kamilix2003/esp-home-sensor/README.md

# esp-home-sensor

Wireless ESP32-C6 based home environmental sensor powered by single Li-ion 18650 cell, running ESP home firmware optimized for battery life which is to be measured in months instead of days.

<figure style="text-align:center;">
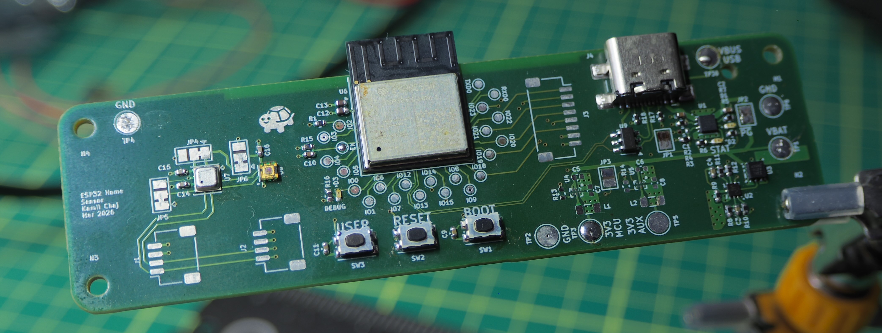
[picture p1: docs/img/full.JPG]
pcb_full
  
</figure>
