kamilix2003/esp-home-sensor/docs/todo.md

# Things to impove in next revision

## Known issues

- DC/DC issues with assembly

## additional features / changes

- additional Battery connector or contacts
- test points for esp32 and other ICs on the backside
- cutout around temperature sennsor
