kamilix2003/esp-home-sensor/hardware/battery_protection/battery_protection.kicad_pcb

## KiCad design hardware/battery_protection/battery_protection.kicad_pcb (2026-10-13)

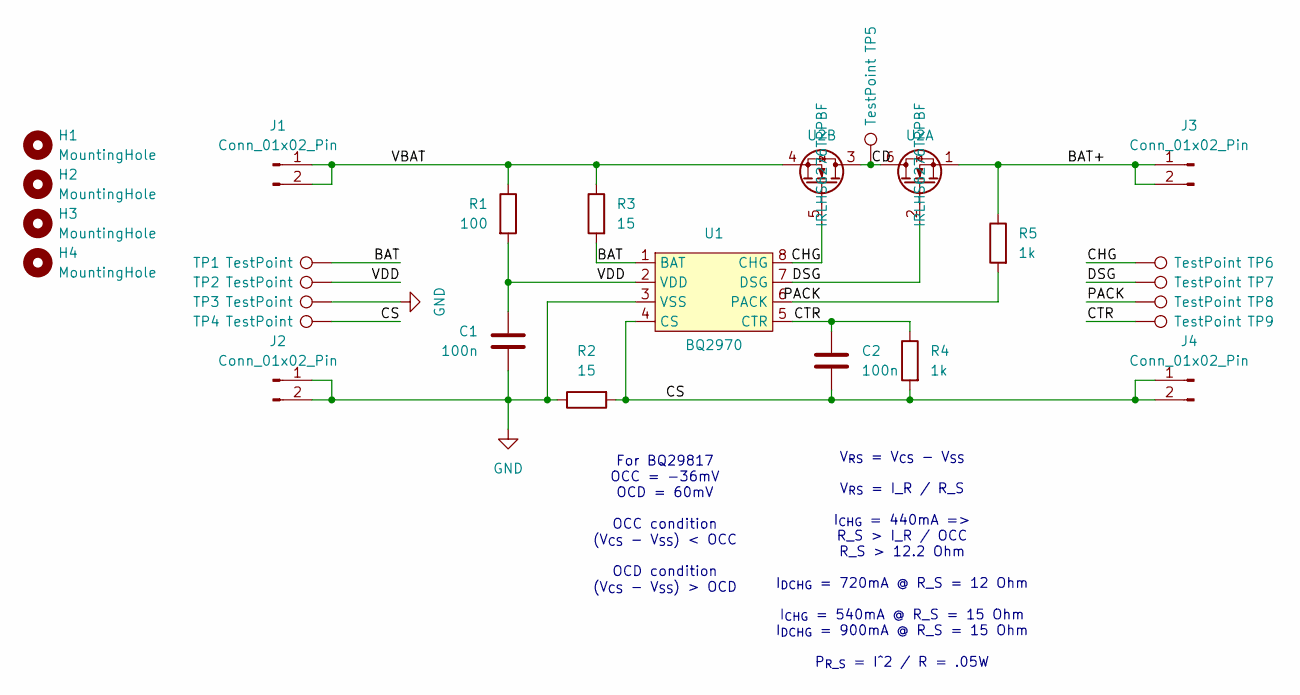
[picture p8: schematic battery_protection.kicad_sch]

Parts:
C1, C2: 100n; C_0402_1005Metric
H1, H2, H3, H4: MountingHole; MountingHole_2.2mm_M2
J1, J2, J3, J4: Conn_01x02_Pin; PinHeader_1x02_P2.54mm_Vertical
R1: 100; R_0402_1005Metric
R2, R3: 15; R_0402_1005Metric
R4, R5: 1k; R_0402_1005Metric
TP1, TP2, TP3, TP4, TP5, TP6, TP7, TP8, TP9: TestPoint; TestPoint_THTPad_D1.0mm_Drill0.5mm
U1: BQ2970; QFN-8_1.5x1.5_Pitch0.5mm
U2: IRLHS6276TRPBF; QFN-6_2x2_Pitch0.65mm

Connections:
/BAT: R3.2, TP1.1 (1_1), U1.1 (BAT)
/BAT+: J3.1, J3.2, R5.1, U2.1
/CD: TP5.1 (1_1), U2.3, U2.6
/CHG: TP6.1 (1_1), U1.8 (CHG), U2.5
/CS: C2.2, J4.1, J4.2, R2.2, R4.2, TP4.1 (1_1), U1.4 (CS)
/CTR: C2.1, R4.1, TP9.1 (1_1), U1.5 (CTR)
/DSG: TP7.1 (1_1), U1.7 (DSG), U2.2
/PACK: R5.2, TP8.1 (1_1), U1.6 (PACK)
/VBAT: J1.1, J1.2, R1.1, R3.1, U2.4
/VDD: C1.1, R1.2, TP2.1 (1_1), U1.2 (VDD)
GND: C1.2, J2.1, J2.2, R2.1, TP3.1 (1_1), U1.3 (VSS)

Notes on the sheet:
V_{RS} = V_{CS} - V_{SS} V_{RS} = I_R / R_S I_{CHG} = 440mA => R_S > I_R / OCC R_S > 12.2 Ohm I_{DCHG} = 720mA @ R_S = 12 Ohm I_{CHG} = 540mA @ R_S = 15 Ohm I_{DCHG} = 900mA @ R_S = 15 Ohm P_{R_S} = I^2 / R = .05W
For BQ29817 OCC = -36mV OCD = 60mV OCC condition (V_{CS} - V_{SS}) < OCC OCD condition (V_{CS} - V_{SS}) > OCD

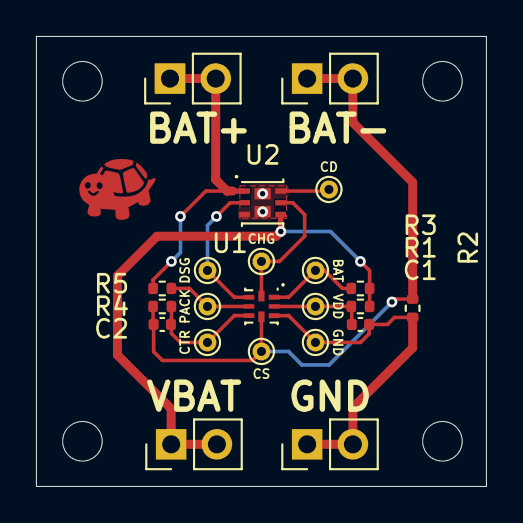
[picture p9: board battery_protection.kicad_pcb from above]

Board: 2 copper layers, 25.0 x 25.0 mm, 26 parts (0 on the bottom side), 11 nets.
