kamilix2003/esp-home-sensor/hardware/battery_charger/battery_charger.kicad_pcb

## KiCad design hardware/battery_charger/battery_charger.kicad_pcb (2026-10-13)

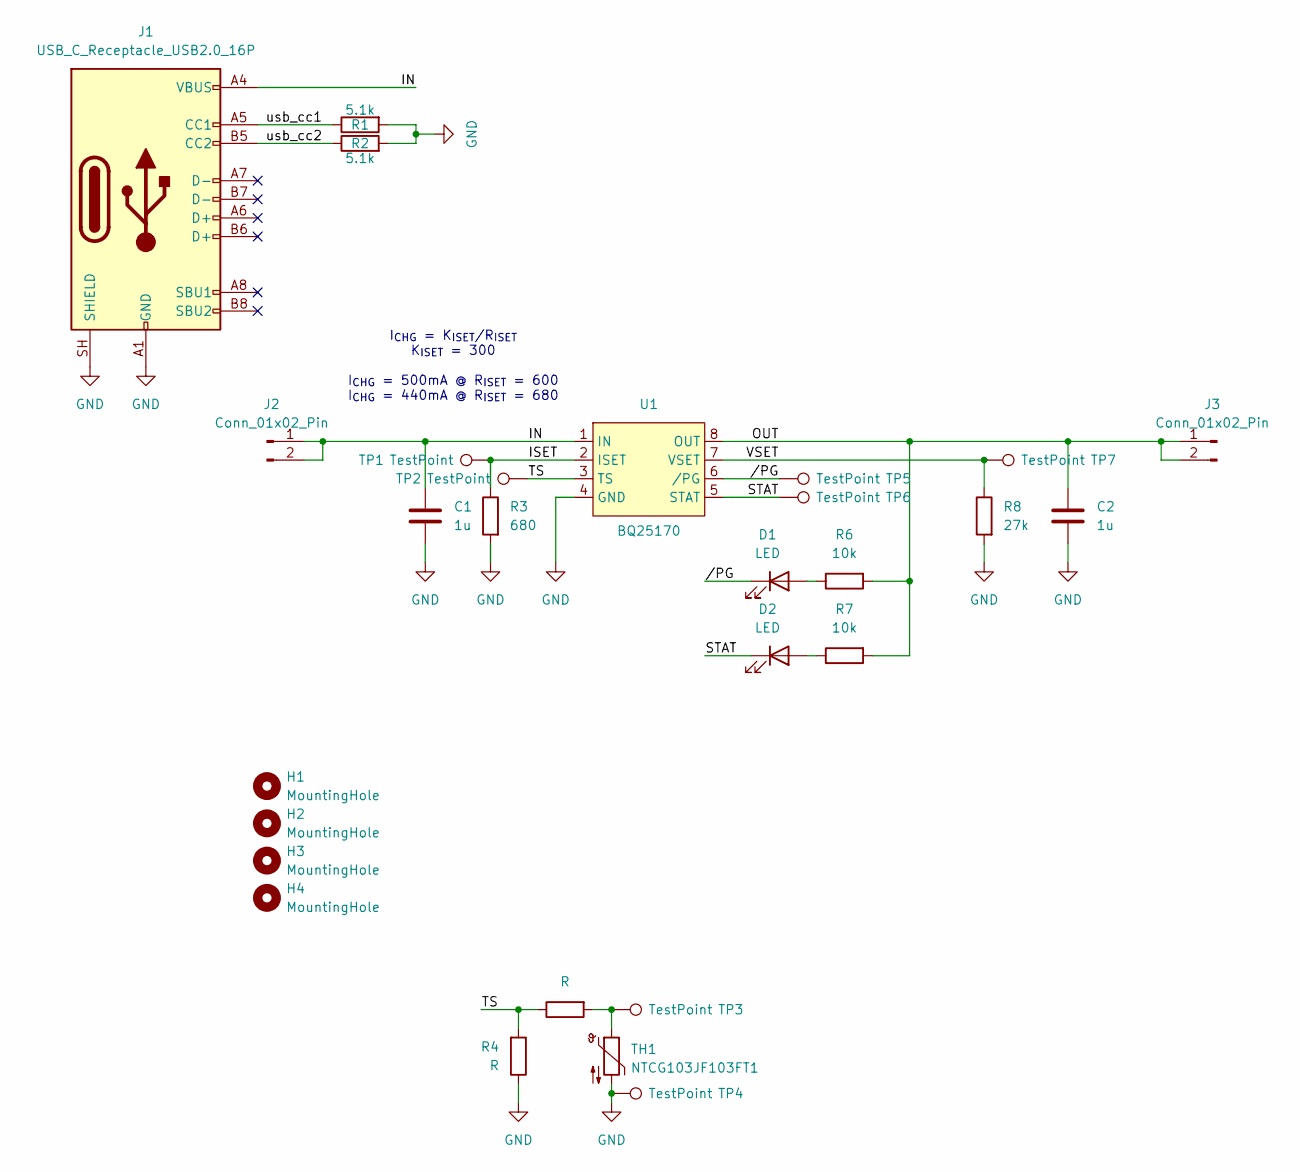
[picture p10: schematic battery_charger.kicad_sch]

Parts:
C1, C2: 1u; C_0402_1005Metric
D1, D2: LED; LED_0402_1005Metric
H1, H2, H3, H4: MountingHole; MountingHole_2.2mm_M2
J1: USB_C_Receptacle_USB2.0_16P; USB_C_Receptacle_GCT_USB4110
J2, J3: Conn_01x02_Pin; PinHeader_1x02_P2.54mm_Vertical
R1, R2: 5.1k; R_0402_1005Metric
R3: 680; R_0402_1005Metric
R4, R5: R; R_0402_1005Metric
R6, R7: 10k; R_0402_1005Metric
R8: 27k; R_0402_1005Metric
TH1: NTCG103JF103FT1; R_0603_1608Metric
TP1, TP2, TP3, TP4, TP5, TP6, TP7: TestPoint; TestPoint_THTPad_D1.0mm_Drill0.5mm
U1: BQ25170; QFN-8_EP_2x2_Pitch0.5mm

Connections:
/IN: C1.1, J1.A4 (VBUS), J1.A9 (VBUS), J1.B4 (VBUS), J1.B9 (VBUS), J2.1, J2.2, U1.1 (IN)
/ISET: R3.1, TP1.1 (1_1), U1.2 (ISET)
/OUT: C2.1, J3.1, J3.2, R6.2, R7.2, U1.8 (OUT)
/STAT: D2.1 (K), TP6.1 (1_1), U1.5 (STAT)
/TS: R4.2, R5.1, TP2.1 (1_1), U1.3 (TS)
/VSET: R8.1, TP7.1 (1_1), U1.7 (VSET)
/usb_cc1: J1.A5 (CC1), R1.1
/usb_cc2: J1.B5 (CC2), R2.1
//PG: D1.1 (K), TP5.1 (1_1), U1.6 (/PG)
GND: C1.2, C2.2, J1.A1 (GND), J1.A12 (GND), J1.B1 (GND), J1.B12 (GND), J1.SH (SHIELD), R1.2, R2.2, R3.2, R4.1, R8.2, TH1.2, TP4.1 (1_1), U1.4 (GND)
unnamed: D1.2 (A), R6.1
unnamed: D2.2 (A), R7.1
unnamed: R5.2, TH1.1, TP3.1 (1_1)

Notes on the sheet:
I_{CHG} = K_{ISET}/R_{ISET} K_{ISET} = 300 I_{CHG} = 500mA @ R_{ISET} = 600 I_{CHG} = 440mA @ R_{ISET} = 680

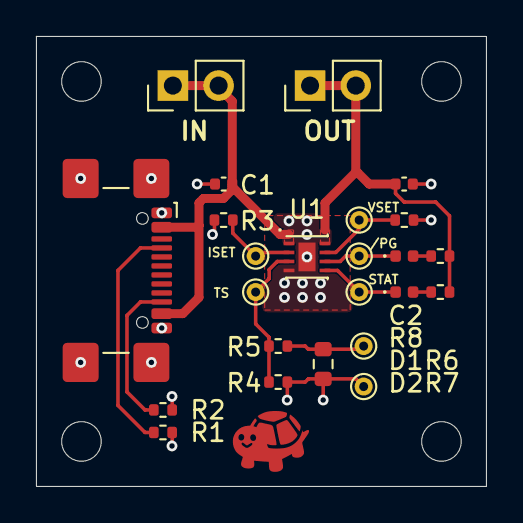
[picture p11: board battery_charger.kicad_pcb from above]

Board: 2 copper layers, 25.0 x 25.0 mm, 28 parts (0 on the bottom side), 13 nets.
