kamilix2003/esp-home-sensor/hardware/esp_home_sensor/esp_home_sensor.kicad_pcb

## KiCad design hardware/esp_home_sensor/esp_home_sensor.kicad_pcb (2026-04-01)

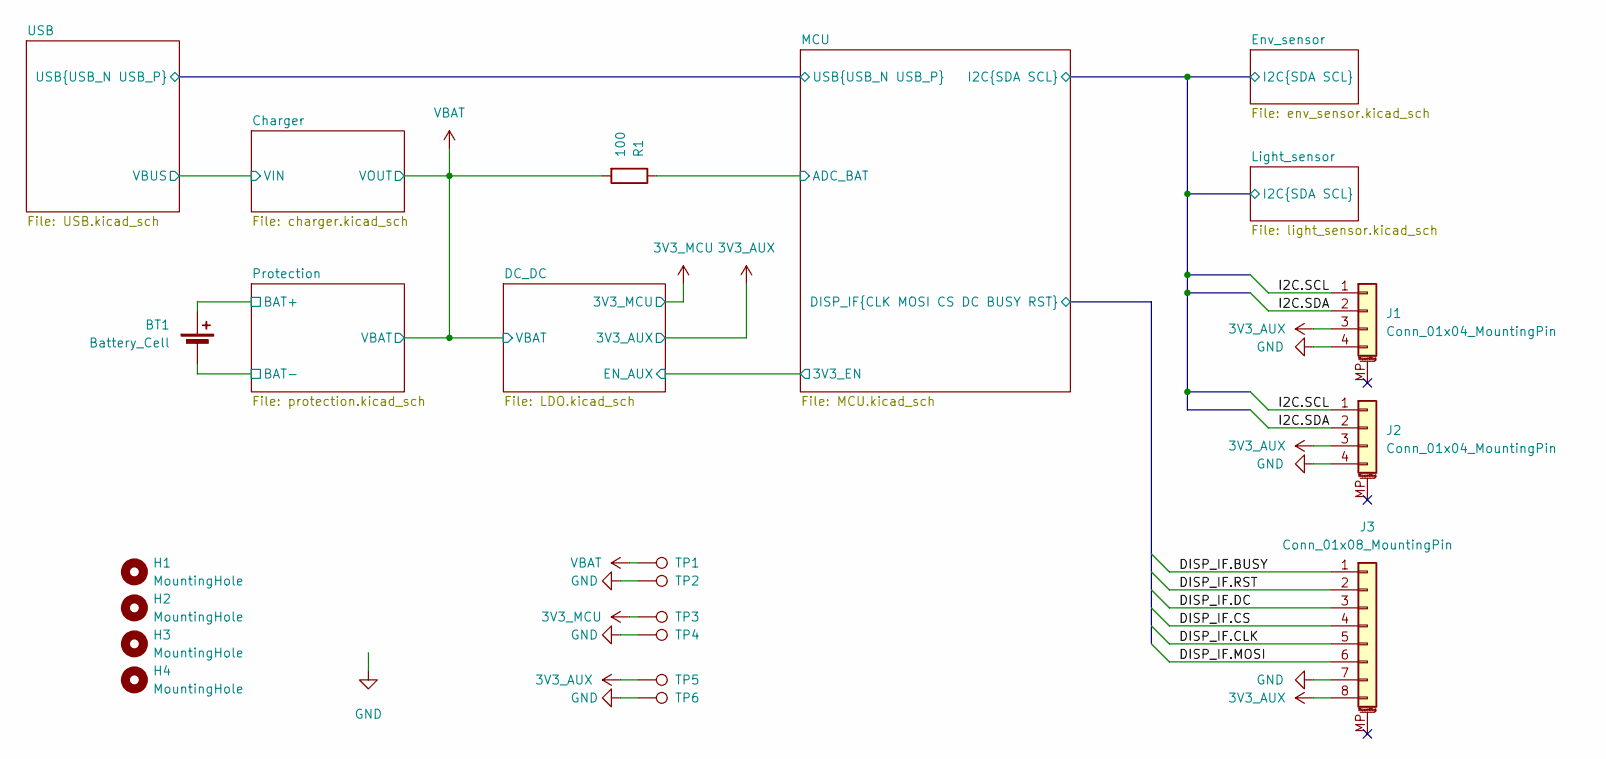
[picture p12: schematic esp_home_sensor.kicad_sch]

Parts:
BT1: Battery_Cell
H1, H2, H3, H4: MountingHole; MountingHole_2.2mm_M2
J1, J2: Conn_01x04_MountingPin; JST_SH_SM04B-SRSS-TB_1x04-1MP_P1.00mm_Horizontal
J3: Conn_01x08_MountingPin; JST_SH_SM08B-SRSS-TB_1x08-1MP_P1.00mm_Horizontal
R1: 100; R_0402_1005Metric
TP1, TP2, TP3, TP4, TP5, TP6: TestPoint; TestPoint_Pad_D2.5mm

Connections:
3V3_AUX: J1.3, J2.3, J3.8, TP5.1 (1_1); also elsewhere on the board
3V3_MCU: TP3.1 (1_1); also elsewhere on the board
/Env_sensor/I2C.SCL: J1.1, J2.1; also elsewhere on the board
/Env_sensor/I2C.SDA: J1.2, J2.2; also elsewhere on the board
/MCU/ADC_BAT: R1.1; also elsewhere on the board
/MCU/DISP_IF.BUSY: J3.1; also elsewhere on the board
/MCU/DISP_IF.CLK: J3.5; also elsewhere on the board
/MCU/DISP_IF.CS: J3.4; also elsewhere on the board
/MCU/DISP_IF.DC: J3.3; also elsewhere on the board
/MCU/DISP_IF.MOSI: J3.6; also elsewhere on the board
/MCU/DISP_IF.RST: J3.2; also elsewhere on the board
/Protection/BAT+: BT1.1 (+); also elsewhere on the board
/Protection/BAT-: BT1.2 (-); also elsewhere on the board
GND: J1.4, J2.4, J3.7, TP2.1 (1_1), TP4.1 (1_1), TP6.1 (1_1); also elsewhere on the board
VBAT: R1.2, TP1.1 (1_1); also elsewhere on the board

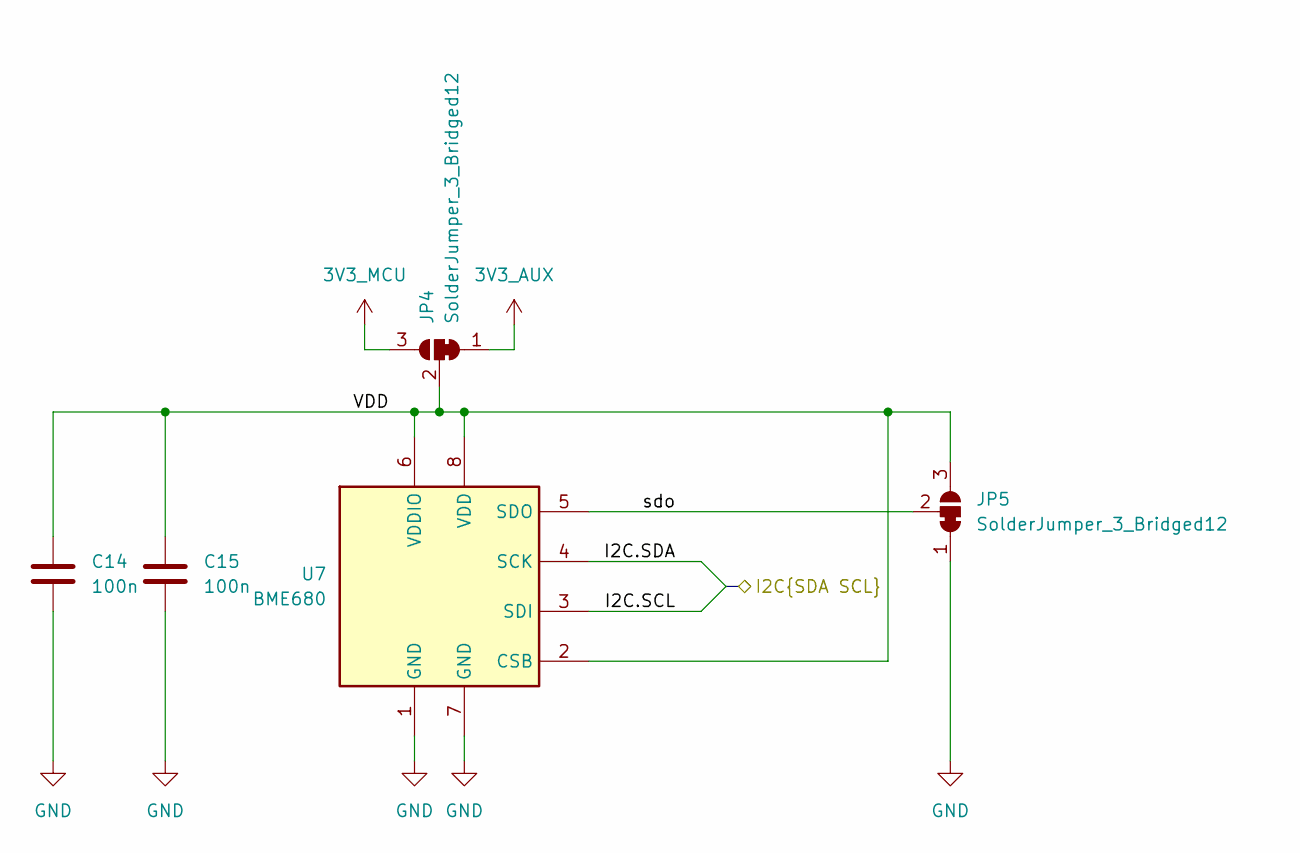
[picture p13: schematic env_sensor.kicad_sch]

Parts:
C14, C15: 100n; C_0402_1005Metric
JP4, JP5: SolderJumper_3_Bridged12; SolderJumper-3_P1.3mm_Bridged12_Pad1.0x1.5mm
U7: BME680; Bosch_LGA-8_3x3mm_P0.8mm_ClockwisePinNumbering

Connections:
3V3_AUX: JP4.1 (A); also elsewhere on the board
3V3_MCU: JP4.3 (B); also elsewhere on the board
/Env_sensor/I2C.SCL: U7.3 (SDI); also elsewhere on the board
/Env_sensor/I2C.SDA: U7.4 (SCK); also elsewhere on the board
/Env_sensor/VDD: C14.1, C15.1, JP4.2 (C), JP5.3 (B), U7.2 (CSB), U7.6 (VDDIO), U7.8 (VDD)
/Env_sensor/sdo: JP5.2 (C), U7.5 (SDO)
GND: C14.2, C15.2, JP5.1 (A), U7.1 (GND), U7.7 (GND); also elsewhere on the board

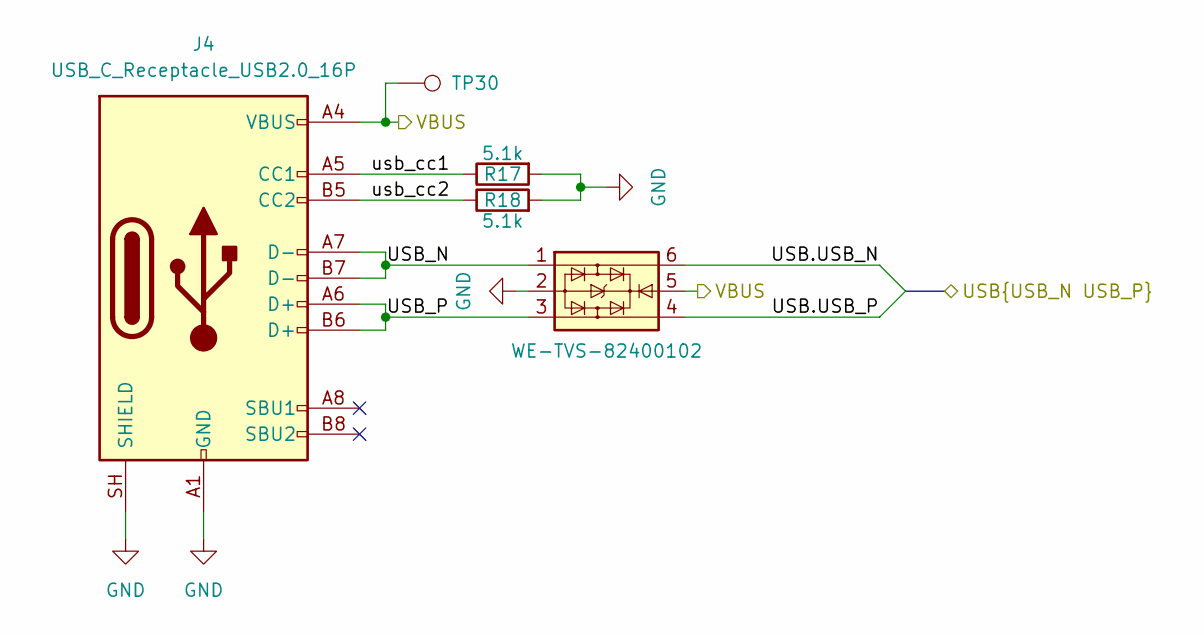
[picture p14: schematic USB.kicad_sch]

Parts:
J4: USB_C_Receptacle_USB2.0_16P; USB_C_Receptacle_GCT_USB4110
R17, R18: 5.1k; R_0402_1005Metric
TP30: TestPoint; TestPoint_Pad_D2.5mm
U9: WE-TVS-82400102; SOT-23-6

Connections:
/Charger/VIN: J4.A4 (VBUS), J4.A9 (VBUS), J4.B4 (VBUS), J4.B9 (VBUS), TP30.1 (1_1), U9.5; also elsewhere on the board
/MCU/USB.USB_N: U9.6; also elsewhere on the board
/MCU/USB.USB_P: U9.4; also elsewhere on the board
/USB/USB_N: J4.A7 (D-), J4.B7 (D-), U9.1
/USB/USB_P: J4.A6 (D+), J4.B6 (D+), U9.3
/USB/usb_cc1: J4.A5 (CC1), R17.1
/USB/usb_cc2: J4.B5 (CC2), R18.1
GND: J4.A1 (GND), J4.A12 (GND), J4.B1 (GND), J4.B12 (GND), J4.SH (SHIELD), R17.2, R18.2, U9.2; also elsewhere on the board

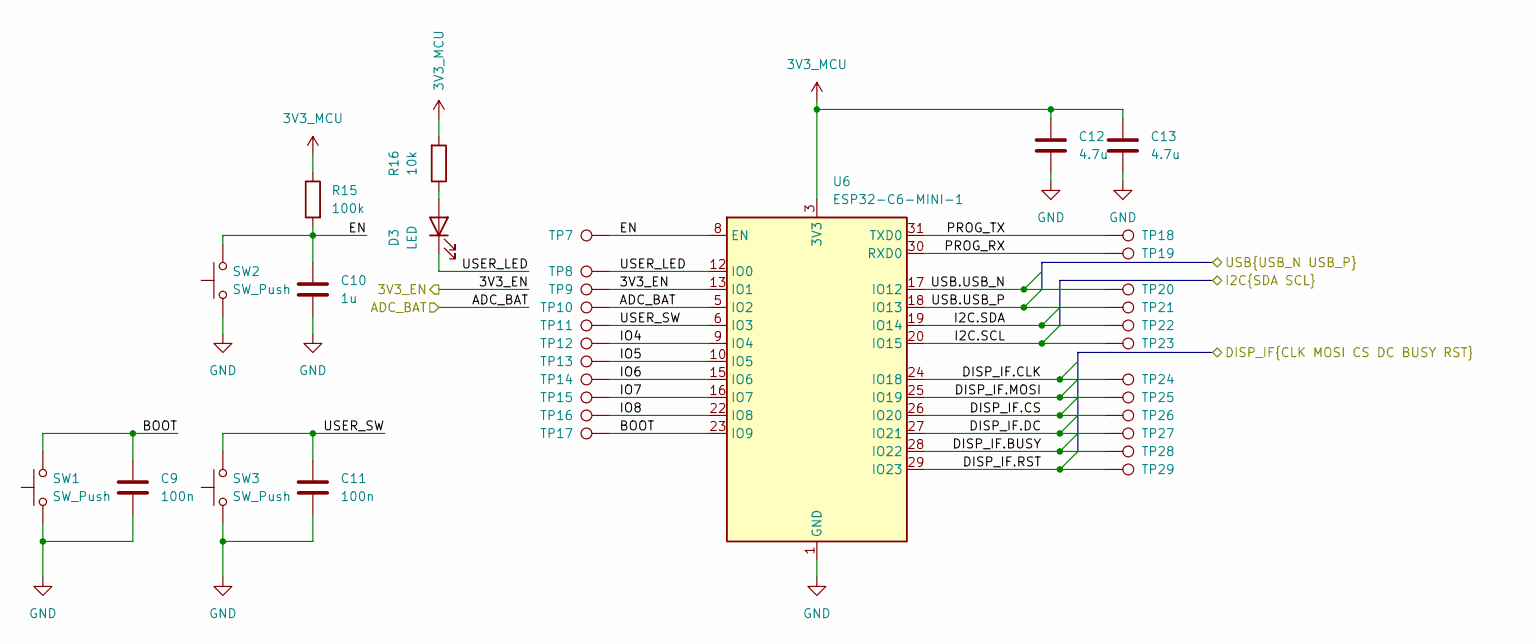
[picture p15: schematic MCU.kicad_sch]

Parts:
C9, C11: 100n; C_0402_1005Metric
C10: 1u; C_0402_1005Metric
C12, C13: 4.7u; C_0402_1005Metric
D3: LED; LED_0402_1005Metric
R15: 100k; R_0402_1005Metric
R16: 10k; R_0402_1005Metric
SW1, SW2, SW3: SW_Push; SW_Push_1P1T_NO_CK_KMR2
TP7, TP8, TP9, TP10, TP11, TP12, TP13, TP14, TP15, TP16, TP17, TP18, TP19, TP20, TP21, TP22, TP23, TP24, TP25, TP26, TP27, TP28, TP29: TestPoint; TestPoint_Pad_D1.0mm
U6: ESP32-C6-MINI-1

Connections:
3V3_MCU: C12.1, C13.1, R15.1, R16.2, U6.3 (3V3); also elsewhere on the board
/DC_DC/EN: TP9.1 (1_1), U6.13 (IO1); also elsewhere on the board
/Env_sensor/I2C.SCL: TP23.1 (1_1), U6.20 (IO15); also elsewhere on the board
/Env_sensor/I2C.SDA: TP22.1 (1_1), U6.19 (IO14); also elsewhere on the board
/MCU/ADC_BAT: TP10.1 (1_1), U6.5 (IO2); also elsewhere on the board
/MCU/BOOT: C9.1, SW1.2, TP17.1 (1_1), U6.23 (IO9)
/MCU/DISP_IF.BUSY: TP28.1 (1_1), U6.28 (IO22); also elsewhere on the board
/MCU/DISP_IF.CLK: TP24.1 (1_1), U6.24 (IO18); also elsewhere on the board
/MCU/DISP_IF.CS: TP26.1 (1_1), U6.26 (IO20); also elsewhere on the board
/MCU/DISP_IF.DC: TP27.1 (1_1), U6.27 (IO21); also elsewhere on the board
/MCU/DISP_IF.MOSI: TP25.1 (1_1), U6.25 (IO19); also elsewhere on the board
/MCU/DISP_IF.RST: TP29.1 (1_1), U6.29 (IO23); also elsewhere on the board
/MCU/EN: C10.1, R15.2, SW2.2, TP7.1 (1_1), U6.8 (EN)
/MCU/IO4: TP12.1 (1_1), U6.9 (IO4)
/MCU/IO5: TP13.1 (1_1), U6.10 (IO5)
/MCU/IO6: TP14.1 (1_1), U6.15 (IO6)
/MCU/IO7: TP15.1 (1_1), U6.16 (IO7)
/MCU/IO8: TP16.1 (1_1), U6.22 (IO8)
/MCU/PROG_RX: TP19.1 (1_1), U6.30 (RXD0)
/MCU/PROG_TX: TP18.1 (1_1), U6.31 (TXD0)
/MCU/USB.USB_N: TP20.1 (1_1), U6.17 (IO12); also elsewhere on the board
/MCU/USB.USB_P: TP21.1 (1_1), U6.18 (IO13); also elsewhere on the board
/MCU/USER_LED: D3.1 (K), TP8.1 (1_1), U6.12 (IO0)
/MCU/USER_SW: C11.1, SW3.2, TP11.1 (1_1), U6.6 (IO3)
GND: C9.2, C10.2, C11.2, C12.2, C13.2, SW1.1, SW2.1, SW3.1, U6.1 (GND), U6.2 (GND), U6.11 (GND), U6.14 (GND), U6.36 (GND), U6.37 (GND), U6.38 (GND), U6.39 (GND), U6.40 (GND), U6.41 (GND), U6.42 (GND), U6.43 (GND), U6.44 (GND), U6.45 (GND), U6.46 (GND), U6.47 (GND), U6.48 (GND), U6.49 (GND), U6.50 (GND), U6.51 (GND), U6.52 (GND), U6.53 (GND); also elsewhere on the board
unnamed: D3.2 (A), R16.1

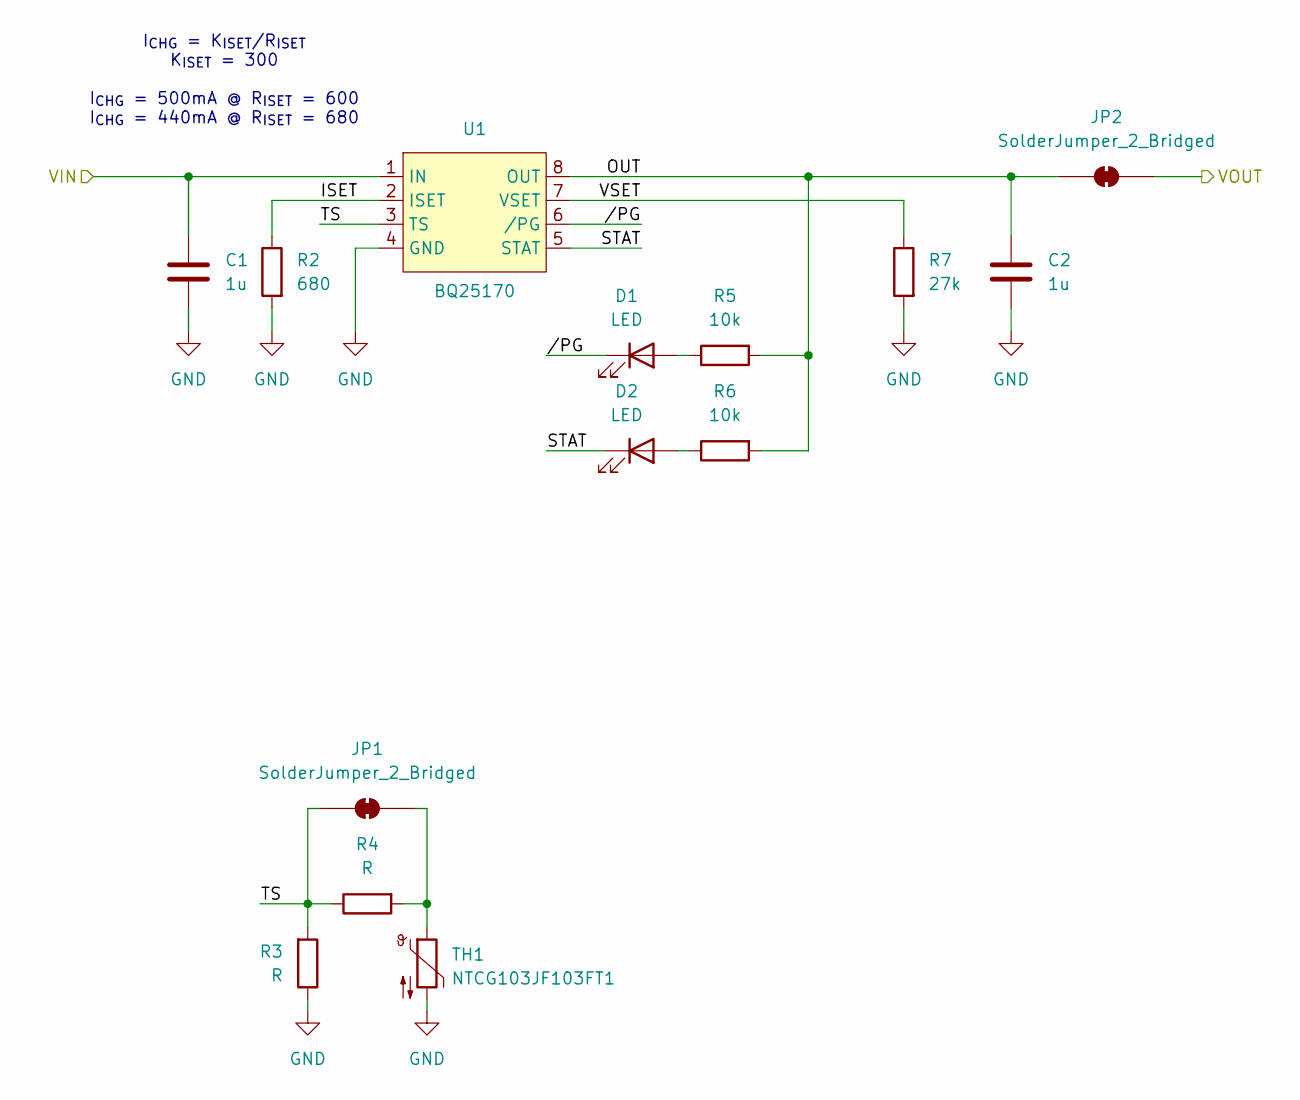
[picture p16: schematic charger.kicad_sch]

Parts:
C1, C2: 1u; C_0402_1005Metric
D1, D2: LED; LED_0402_1005Metric
JP1, JP2: SolderJumper_2_Bridged; SolderJumper-2_P1.3mm_Bridged2Bar_Pad1.0x1.5mm
R2: 680; R_0402_1005Metric
R3, R4: R; R_0402_1005Metric
R5, R6: 10k; R_0402_1005Metric
R7: 27k; R_0402_1005Metric
TH1: NTCG103JF103FT1; R_0603_1608Metric
U1: BQ25170; QFN-8_EP_2x2_Pitch0.5mm

Connections:
/Charger/ISET: R2.1, U1.2 (ISET)
/Charger/OUT: C2.1, JP2.1 (A), R5.2, R6.2, U1.8 (OUT)
/Charger/STAT: D2.1 (K), U1.5 (STAT)
/Charger/TS: JP1.1 (A), R3.2, R4.1, U1.3 (TS)
/Charger/VIN: C1.1, U1.1 (IN); also elsewhere on the board
/Charger/VSET: R7.1, U1.7 (VSET)
/Charger//PG: D1.1 (K), U1.6 (/PG)
GND: C1.2, C2.2, R2.2, R3.1, R7.2, TH1.2, U1.4 (GND); also elsewhere on the board
unnamed: D1.2 (A), R5.1
unnamed: D2.2 (A), R6.1
unnamed: JP1.2 (B), R4.2, TH1.1
VBAT: JP2.2 (B); also elsewhere on the board

Notes on the sheet:
I_{CHG} = K_{ISET}/R_{ISET} K_{ISET} = 300 I_{CHG} = 500mA @ R_{ISET} = 600 I_{CHG} = 440mA @ R_{ISET} = 680

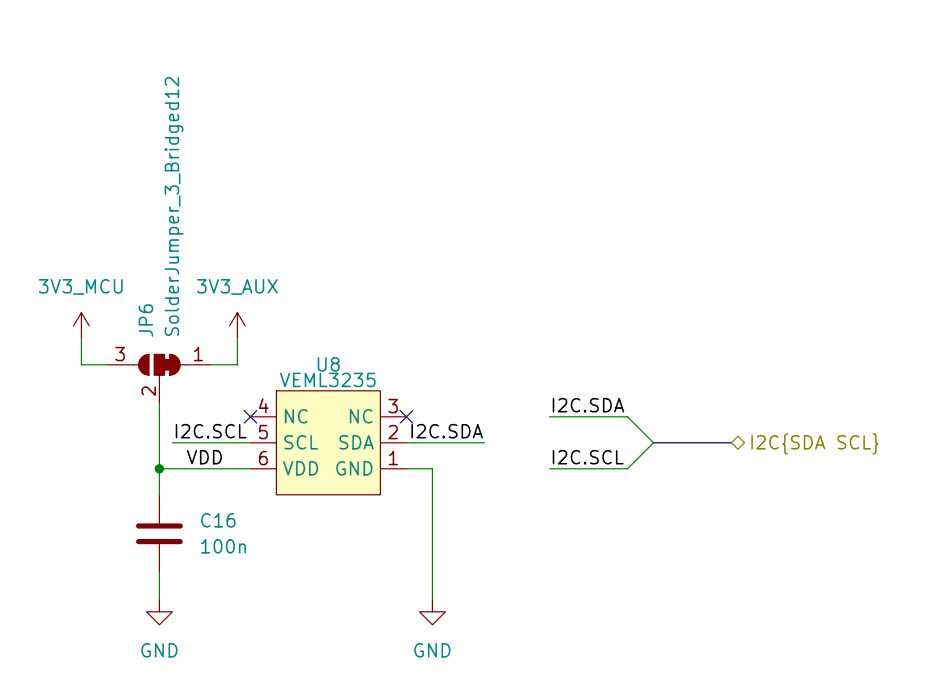
[picture p17: schematic light_sensor.kicad_sch]

Parts:
C16: 100n; C_0402_1005Metric
JP6: SolderJumper_3_Bridged12; SolderJumper-3_P1.3mm_Bridged12_Pad1.0x1.5mm
U8: VEML3235

Connections:
3V3_AUX: JP6.1 (A); also elsewhere on the board
3V3_MCU: JP6.3 (B); also elsewhere on the board
/Env_sensor/I2C.SCL: U8.5 (SCL); also elsewhere on the board
/Env_sensor/I2C.SDA: U8.2 (SDA); also elsewhere on the board
/Light_sensor/VDD: C16.1, JP6.2 (C), U8.6 (VDD)
GND: C16.2, U8.1 (GND); also elsewhere on the board

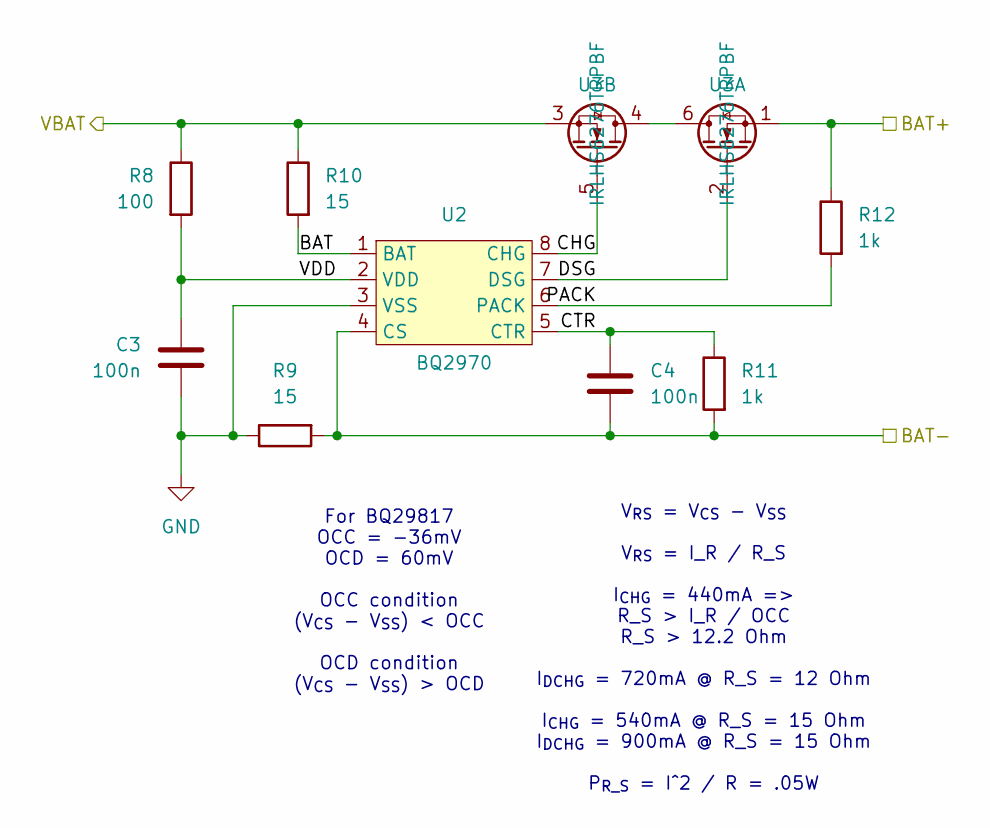
[picture p18: schematic protection.kicad_sch]

Parts:
C3, C4: 100n; C_0402_1005Metric
R8: 100; R_0402_1005Metric
R9, R10: 15; R_0402_1005Metric
R11, R12: 1k; R_0402_1005Metric
U2: BQ2970; QFN-8_1.5x1.5_Pitch0.5mm
U3: IRLHS6276TRPBF; QFN-6_2x2_Pitch0.65mm

Connections:
/Protection/BAT: R10.2, U2.1 (BAT)
/Protection/BAT+: R12.1, U3.1; also elsewhere on the board
/Protection/BAT-: C4.2, R9.2, R11.2, U2.4 (CS); also elsewhere on the board
/Protection/CHG: U2.8 (CHG), U3.5
/Protection/CTR: C4.1, R11.1, U2.5 (CTR)
/Protection/DSG: U2.7 (DSG), U3.2
/Protection/PACK: R12.2, U2.6 (PACK)
/Protection/VDD: C3.1, R8.2, U2.2 (VDD)
GND: C3.2, R9.1, U2.3 (VSS); also elsewhere on the board
unnamed: U3.4, U3.6
VBAT: R8.1, R10.1, U3.3; also elsewhere on the board

Notes on the sheet:
V_{RS} = V_{CS} - V_{SS} V_{RS} = I_R / R_S I_{CHG} = 440mA => R_S > I_R / OCC R_S > 12.2 Ohm I_{DCHG} = 720mA @ R_S = 12 Ohm I_{CHG} = 540mA @ R_S = 15 Ohm I_{DCHG} = 900mA @ R_S = 15 Ohm P_{R_S} = I^2 / R = .05W
For BQ29817 OCC = -36mV OCD = 60mV OCC condition (V_{CS} - V_{SS}) < OCC OCD condition (V_{CS} - V_{SS}) > OCD

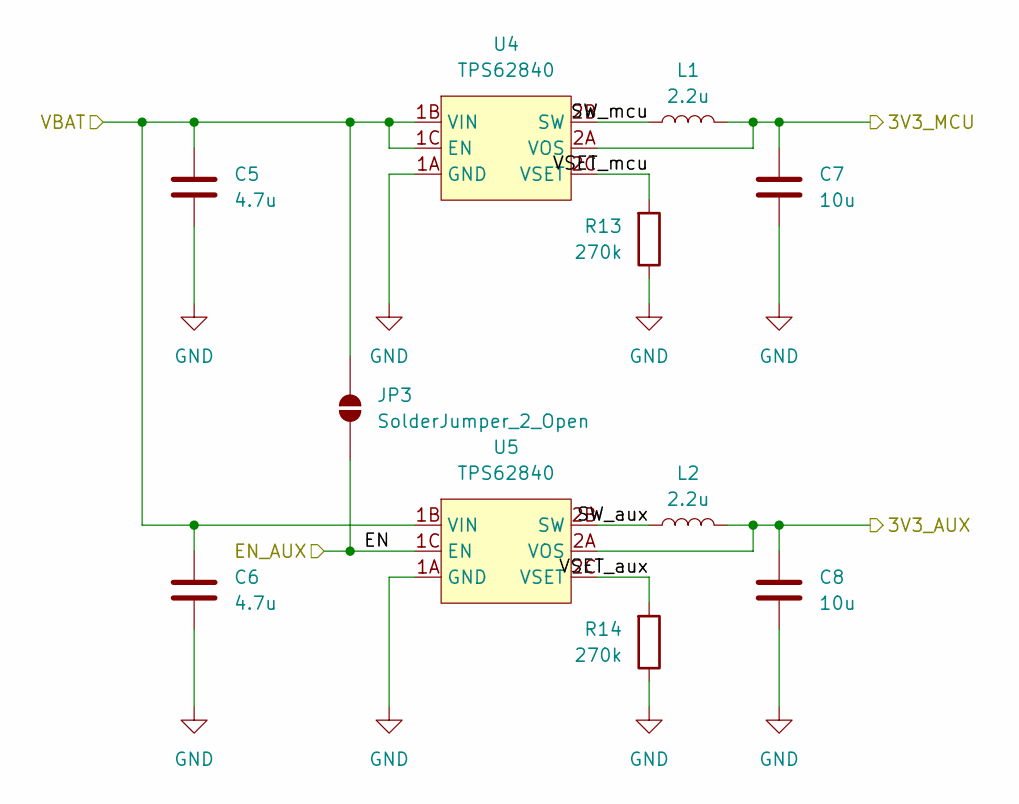
[picture p19: schematic LDO.kicad_sch]

Parts:
C5, C6: 4.7u; C_0402_1005Metric
C7, C8: 10u; C_0402_1005Metric
JP3: SolderJumper_2_Open; SolderJumper-2_P1.3mm_Open_Pad1.0x1.5mm
L1, L2: 2.2u; L_0805_2012Metric
R13, R14: 270k; R_0402_1005Metric
U4, U5: TPS62840; BGA-6_2x3_1.5x1.2mm

Connections:
3V3_AUX: C8.1, L2.2, U5.2A (VOS); also elsewhere on the board
3V3_MCU: C7.1, L1.2, U4.2A (VOS); also elsewhere on the board
/DC_DC/EN: JP3.1 (A), U5.1C (EN); also elsewhere on the board
/DC_DC/SW_aux: L2.1, U5.2B (SW)
/DC_DC/SW_mcu: L1.1, U4.2B (SW)
/DC_DC/VSET_aux: R14.2, U5.2C (VSET)
/DC_DC/VSET_mcu: R13.2, U4.2C (VSET)
GND: C5.2, C6.2, C7.2, C8.2, R13.1, R14.1, U4.1A (GND), U5.1A (GND); also elsewhere on the board
VBAT: C5.1, C6.1, JP3.2 (B), U4.1B (VIN), U4.1C (EN), U5.1B (VIN); also elsewhere on the board

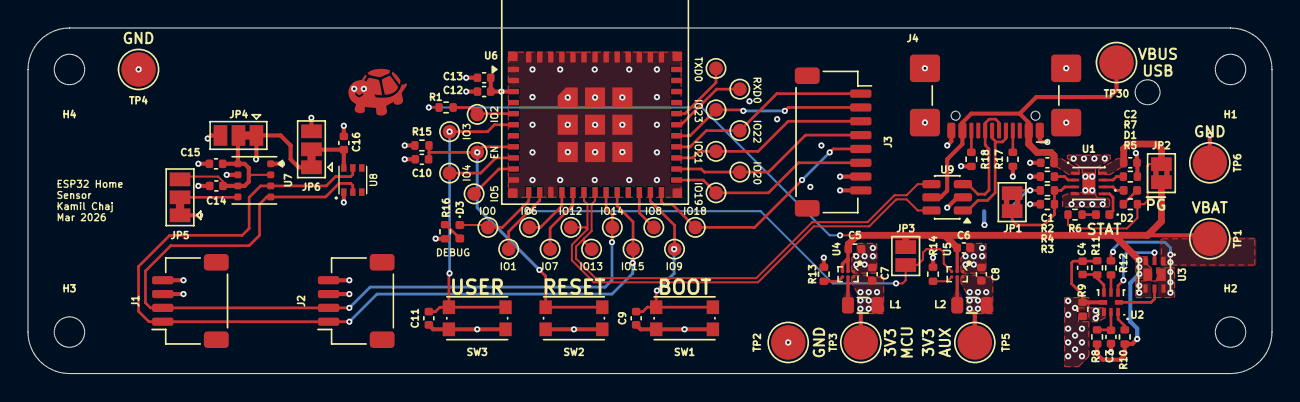
[picture p20: board esp_home_sensor.kicad_pcb from above]

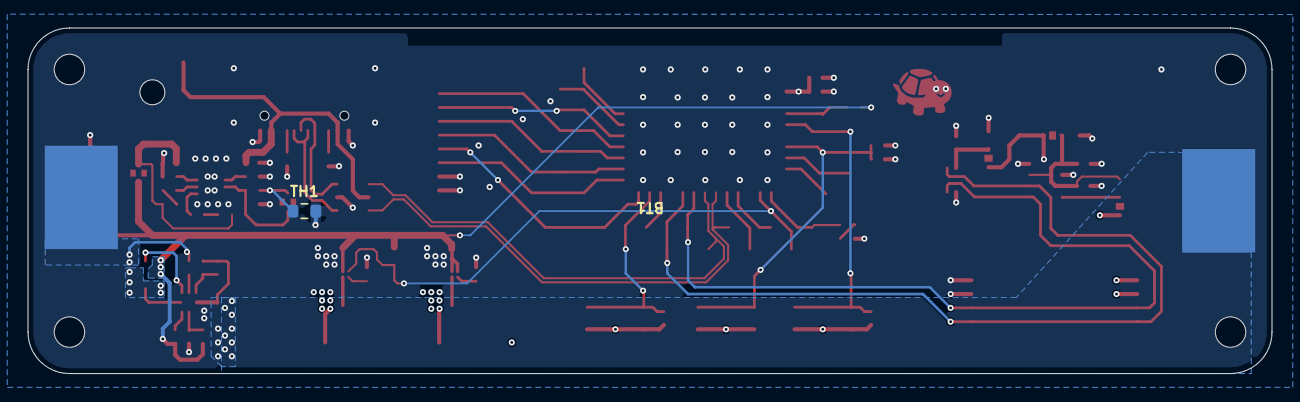
[picture p21: board esp_home_sensor.kicad_pcb from below]

Board: 4 copper layers, 90.0 x 25.0 mm, 97 parts (2 on the bottom side), 58 nets.
