kamilix2003/esp-home-sensor/(commit log)

2026-03-20 init kicad
    [esp_home_sensor.kicad_pcb, esp_home_sensor.kicad_sch]
2026-03-21 busses, display connector, footprint lib
    [MCU.kicad_sch, USB.kicad_sch, env_sensor.kicad_sch, esp_home_sensor.kicad_pcb, esp_home_sensor.kicad_sch, light_sensor.kicad_sch, protection.kicad_sch]
2026-03-23 footprint assignment, buck
    [LDO.kicad_sch, MCU.kicad_sch, USB.kicad_sch, charger_sim.kicad_sch, env_sensor.kicad_sch, esp_home_sensor.kicad_sch, light_sensor.kicad_sch, protection.kicad_sch]
2026-03-23 minor update
    [LDO.kicad_sch, MCU.kicad_sch, charger.kicad_sch, env_sensor.kicad_sch, esp_home_sensor.kicad_pcb, esp_home_sensor.kicad_sch, light_sensor.kicad_sch]
2026-03-26 initial layout, power routing
    [LDO.kicad_sch, MCU.kicad_sch, USB.kicad_sch, charger.kicad_sch, env_sensor.kicad_sch, esp_home_sensor.kicad_pcb, esp_home_sensor.kicad_sch, protection.kicad_sch]
2026-04-01 in production
    [LDO.kicad_sch, MCU.kicad_sch, USB.kicad_sch, charger.kicad_sch, env_sensor.kicad_sch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]
